windnerd-labs/WindNerd-Node/(commit log)

2026-08-24 Add Arduino WTP example with sensor drivers and uploader
    Includes TMAG5273 vane sensor, I2C helper, vector averaging, rolling
    buffer, WTP payload/uploader, wiring photo and docs.
2026-08-27 add improv_serial, esp32_improv and component ids
